hsong7273/Eos_DirectionalSource/schematics/eos_trigger_proto.pdf

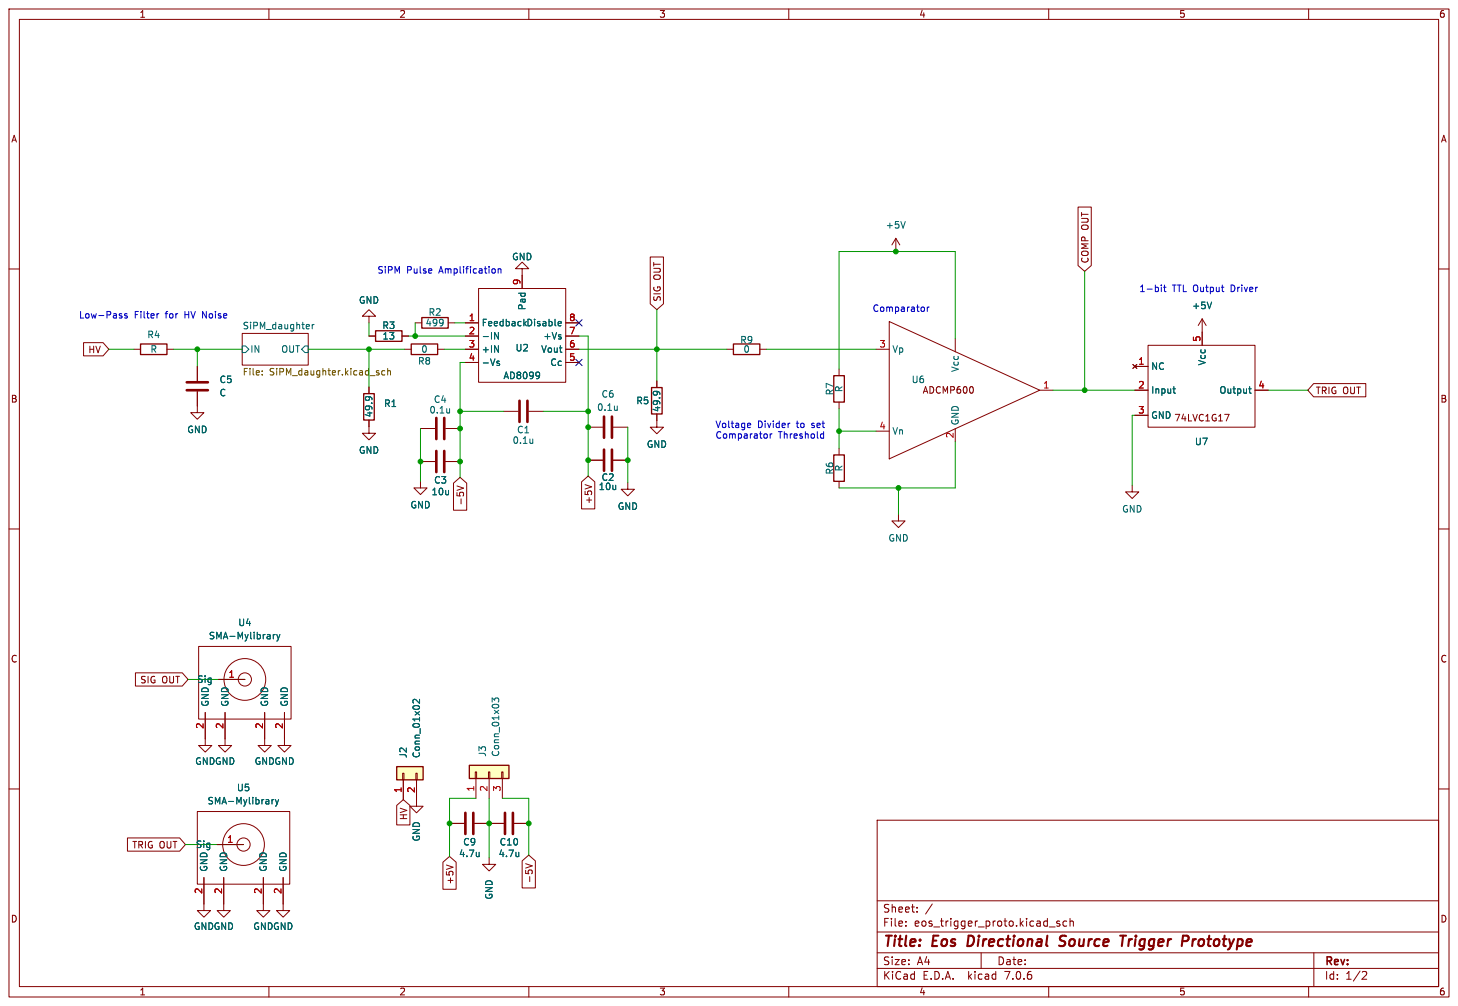
[picture p1: page 1]

2 U5 SMA-Mylibrary GNDGND GNDGND

File: eos_trigger_proto.kicad_sch Sheet: /
Id: 1/2 Title: Eos Directional Source Trigger Prototype
