hsong7273/Eos_DirectionalSource/schematics/v1.0_eos_trigger_proto.pdf

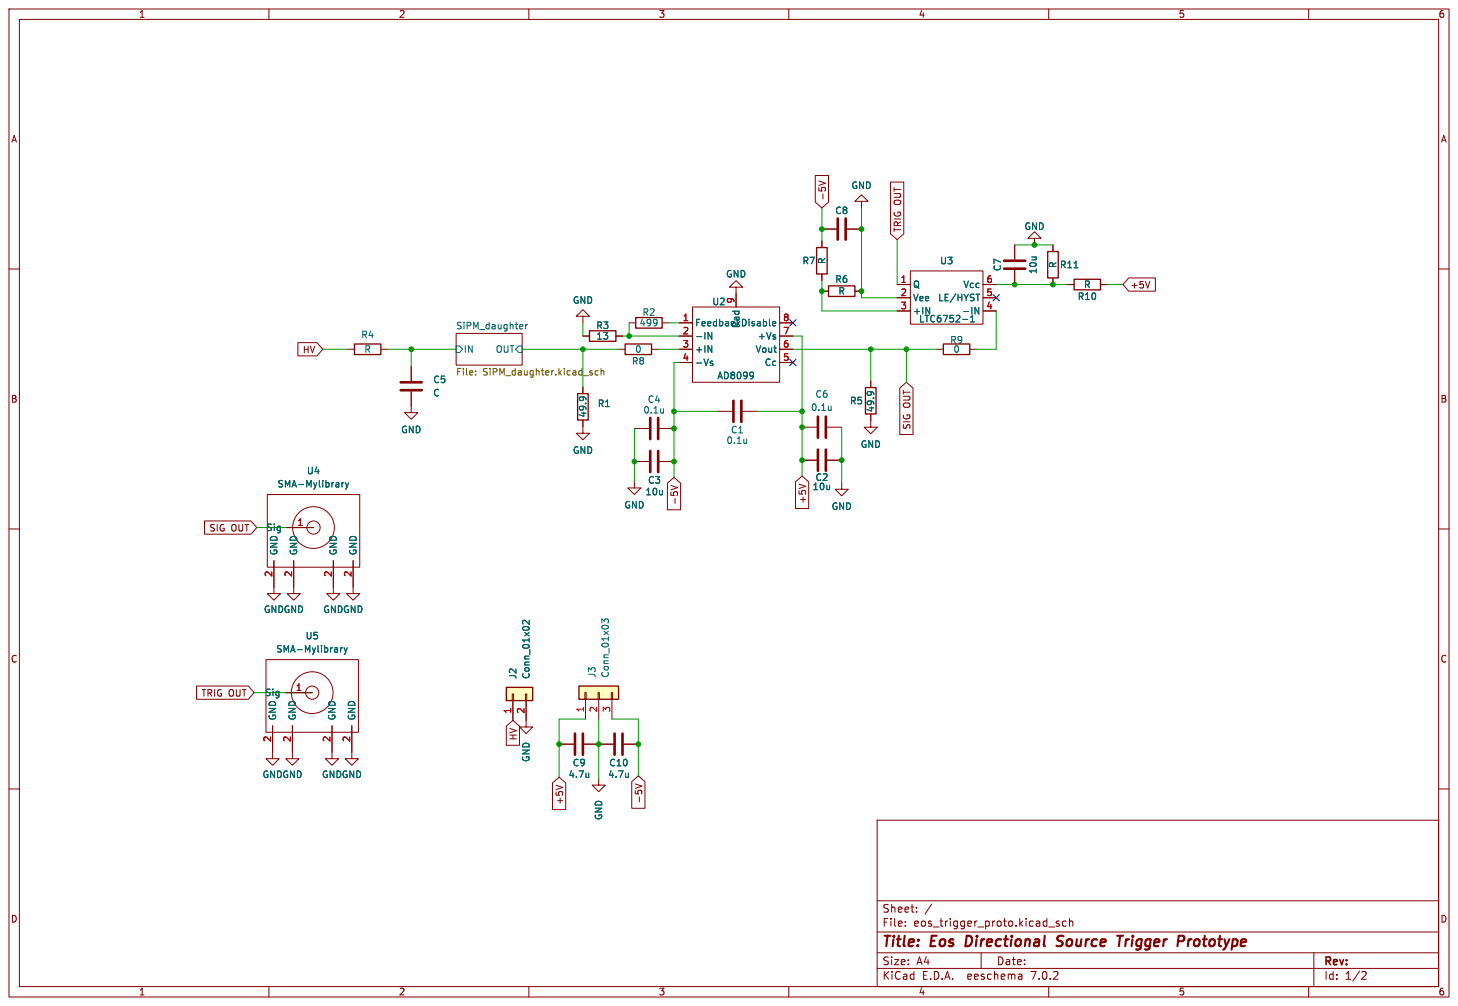
[picture p2: page 1]

2 U4 SMA-Mylibrary GND GNDGND

2 GND GNDGND GNDGND GND

File: eos_trigger_proto.kicad_sch Sheet: /
Id: 1/2 Title: Eos Directional Source Trigger Prototype
