hsong7273/Eos_DirectionalSource/schematics/v1.0_pos_threshold_eos_trigger_proto.pdf

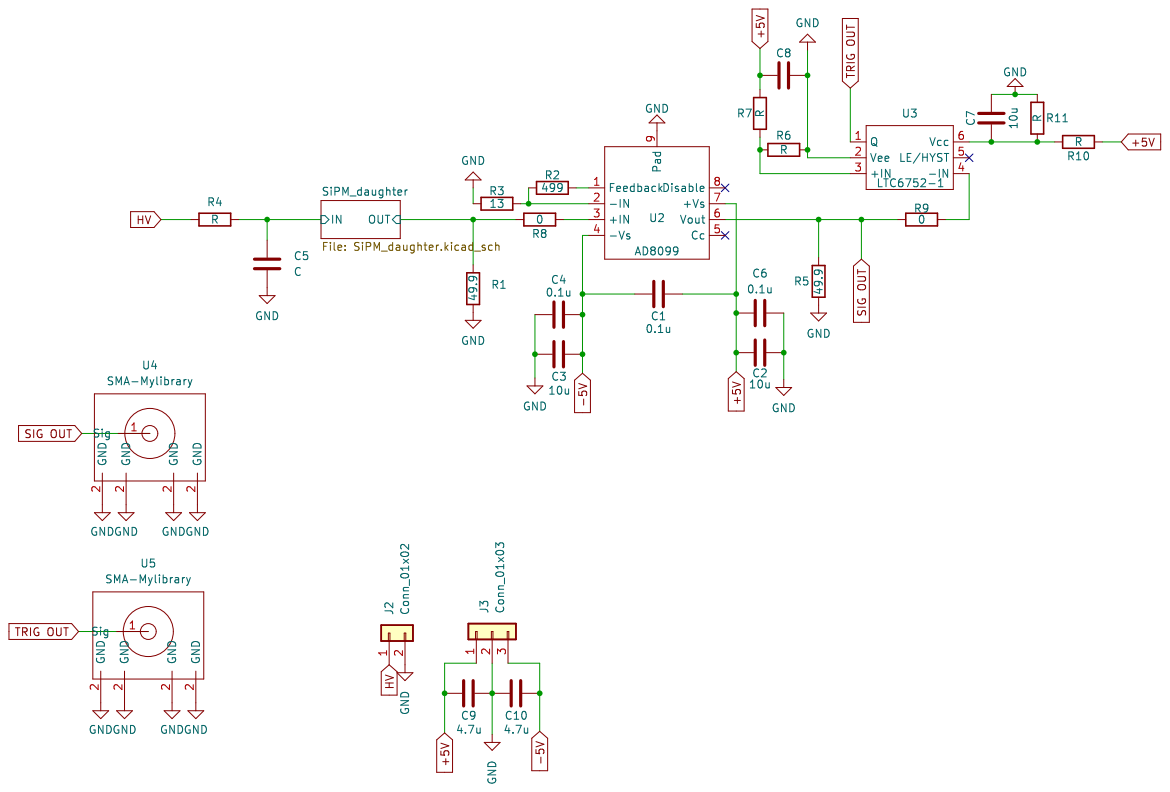
[picture p3: page 1]

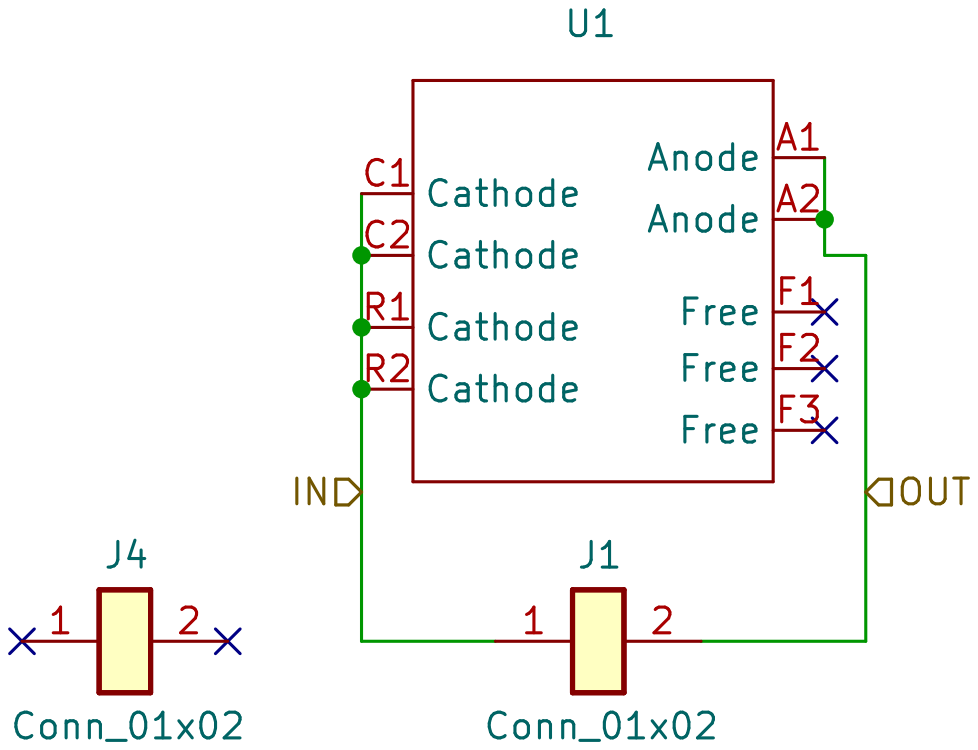
[picture p4: page 2]
