hsong7273/Eos_DirectionalSource/(commit log)

2023-05-29 blank pcb and sch
    [eos_trigger_proto.kicad_pcb, eos_trigger_proto.kicad_sch]
2023-05-29 pcb first pass
    [SiPM_daughter.kicad_sch, eos_trigger_proto.kicad_pcb, eos_trigger_proto.kicad_sch]
2023-05-29 pulled libraries and tweaked sch
    [eos_trigger_proto.kicad_sch]
2023-05-30 cleanup schematics
    [eos_trigger_proto.kicad_sch]
2023-05-30 pcb updates
    [SiPM_daughter.kicad_sch, eos_trigger_proto.kicad_pcb, eos_trigger_proto.kicad_sch]
2023-05-30 sipm board
    [SiPM_daughter.kicad_pcb, SiPM_daughter.kicad_sch, eos_trigger_proto.kicad_pcb, eos_trigger_proto.kicad_sch]
2023-06-01 Rearranged pcb, added short resistors and component values
    [SiPM_daughter.kicad_pcb, eos_trigger_proto.kicad_pcb, eos_trigger_proto.kicad_sch]
2023-06-01 separated opamp and comparator
    [SiPM_daughter.kicad_sch, eos_trigger_proto.kicad_pcb, eos_trigger_proto.kicad_sch]
2023-06-05 ready to print pcb v1.0
    [SiPM_daughter.kicad_sch, eos_trigger_proto.kicad_pcb, eos_trigger_proto.kicad_sch]
2023-06-05 tiled pcbs
    [eos_trigger_proto_panel.kicad_pcb]
2023-06-05 fixed op-amp layout and ground pad
    [SiPM_daughter.kicad_pcb, eos_trigger_proto.kicad_pcb, eos_trigger_proto.kicad_sch]
2023-06-05 update tiled panel
    [eos_trigger_proto.kicad_pcb, eos_trigger_proto_panel.kicad_pcb]
2023-06-05 update pin connector size
    [SiPM_daughter.kicad_pcb, SiPM_daughter.kicad_sch, eos_trigger_proto.kicad_pcb, eos_trigger_proto.kicad_sch, eos_trigger_proto_panel.kicad_pcb]
2023-06-05 update panel
    [eos_trigger_proto_panel.kicad_pcb]
2023-06-06 schematics for v1 and updated ignore
    [eos_trigger_proto.kicad_pcb, eos_trigger_proto_panel.kicad_pcb]
2023-08-03 5V comparator circuit with output driver
    [eos_trigger_proto.kicad_sch]
2023-10-25 2 SiPM AND Trigger Board
    [SiPM_daughter.kicad_pcb, SiPM_daughter.kicad_sch, eos_trigger_proto.kicad_sch]
2023-11-17 trigger output buffer, 2 SiPM PCB
    [eos_trigger_proto.kicad_pcb, eos_trigger_proto.kicad_sch]
2023-11-17 new footprint
